maxlab-io/kiml/ATTRIBUTIONS.md

# List of Files with Custom License and Attributions

---

* File: [3d/00-kiml-optical.3dshapes/m12-120-lens.stp](3d/00-kiml-optical.3dshapes/m12-120-lens.stp)
* Author: Maksym Olender, max@maxlab.io
* License: [CC BY](https://creativecommons.org/licenses/by/4.0/)

---

* File: [3d/00-kiml-optical.3dshapes/BS612-PIR.step](3d/00-kiml-optical.3dshapes/BS612-PIR.step)
* Author: Maksym Olender, max@maxlab.io
* License: [CC BY](https://creativecommons.org/licenses/by/4.0/)

---

* File: [3d/00-kiml-optical.3dshapes/pir_lens_PD05-12005_8308-4.step](3d/00-kiml-optical.3dshapes/pir_lens_PD05-12005_8308-4.step)
* Author: Maksym Olender, max@maxlab.io
* License: [CC BY](https://creativecommons.org/licenses/by/4.0/)

---

* File: [3d/00-kiml-optical.3dshapes/IRCUT.stp](3d/00-kiml-optical.3dshapes/IRCUT.stp)
* Author: Maksym Olender, max@maxlab.io
* License: [CC BY](https://creativecommons.org/licenses/by/4.0/)

---

* File: [3d/ESP32-S3-WROOM-1U--3DModel-STEP-56544.STEP](3d/ESP32-S3-WROOM-1U--3DModel-STEP-56544.STEP)
* Author/Link: [SnapEDA](https://www.snapeda.com/parts/ESP32-S3-WROOM-1U/Espressif%20Systems/view-part/?welcome=home)
* License: [CC BY-SA](https://creativecommons.org/licenses/by/4.0/) with the [Design Exception 1.0](https://www.snapeda.com/about/FAQ/#designexception)
* See also: [SnapEDA licensing explanation](https://support.snapeda.com/en/articles/2957814-what-is-the-license-for-symbols-and-footprints)

---

* File: [3d/00-kiml-connector-rj.3dshapes/HANRUN HR911105A.stp](<3d/00-kiml-connector-rj.3dshapes/HANRUN HR911105A.stp>)
* Author: [Алексей Перевозчиков](https://grabcad.com/0030f7ec23-1)
* Link: [GrabCAD HANRUN HR911105A page](https://grabcad.com/library/hanrun-hr911105a-1)
* License: [GrabCAD License](https://grabcad.com/terms)

---

* File: [3d/00-kiml-connector-phoenix-mc.3dshapes/pxc_1843075_03_00_MCD-1-5-2-G1-3-81_3D.stp](3d/00-kiml-connector-phoenix-mc.3dshapes/pxc_1843075_03_00_MCD-1-5-2-G1-3-81_3D.stp)
* Author: Phoenix Contact
* Link: https://www.phoenixcontact.com/en-ca/products/pcb-header-mcd-15-2-g1-381-1843075

---

* File: [3d/00-kiml-connector-rj.3dshapes/HANRUN HR911105A.stp](<3d/00-kiml-connector-rj.3dshapes/HANRUN HR911105A.stp>)
* Author: [Bernd Giesecke](https://grabcad.com/bernd.giesecke-1)
* Link: [GrabCAD E22-900M22S page](https://grabcad.com/library/e22-900m22s-1)
* License: [GrabCAD License](https://grabcad.com/terms)

---

* File: [3d/00-kiml-connector-barrel-jack.3dshapes/DC_Power_Jack_PCB_Mounted_2.1mm.step](3d/00-kiml-connector-barrel-jack.3dshapes/DC_Power_Jack_PCB_Mounted_2.1mm.step)
* File: [3d/00-kiml-connector-barrel-jack.3dshapes/DC_Power_Jack_PCB_Mounted_2.1mm.wrl](3d/00-kiml-connector-barrel-jack.3dshapes/DC_Power_Jack_PCB_Mounted_2.1mm.wrl)
* Author: [Jimmy Henry](https://grabcad.com/jimmi.henry-1)
* Link: [GrabCAD DC Jack page](https://grabcad.com/library/arduino-dc-barrel-jack-2-1mm-for-kicad-1)
* License: [GrabCAD License](https://grabcad.com/terms)

---

* File: [3d/00-kiml-connector-coaxial/MM8030-2610RK0--3DModel-STEP-56544.STEP](3d/00-kiml-connector-coaxial/MM8030-2610RK0--3DModel-STEP-56544.STEP)
* Author/Link: [SnapEDA](https://www.snapeda.com/parts/MM8030-2610RK0/Murata%20Electronics/view-part/?welcome=home)
* License: [CC BY-SA](https://creativecommons.org/licenses/by/4.0/) with the [Design Exception 1.0](https://www.snapeda.com/about/FAQ/#designexception)
* See also: [SnapEDA licensing explanation](https://support.snapeda.com/en/articles/2957814-what-is-the-license-for-symbols-and-footprints)
