maxlab-io/kiml/3d/00-kiml-connector-coaxial/MM8030-2610RK0--3DModel-STEP-56544.STEP

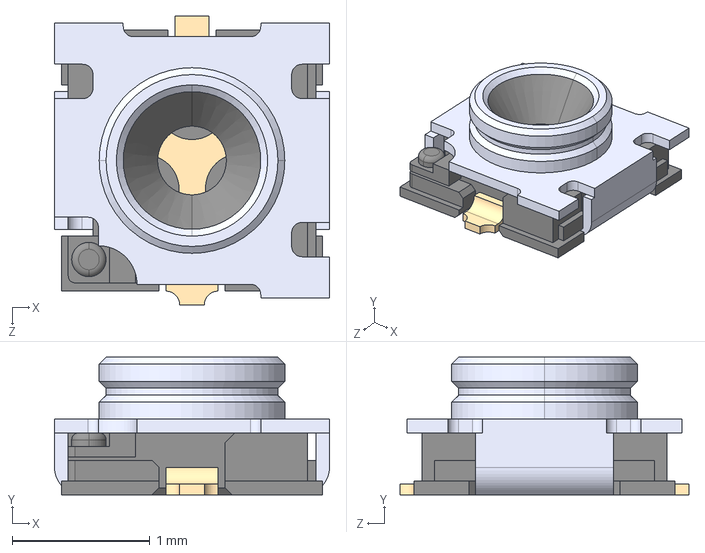
[picture p7: CAD file, 2024-01-03]
3d/00-kiml-connector-coaxial/MM8030-2610RK0--3DModel-STEP-56544.STEP
2.00 x 1.00 x 2.10 mm
