maxlab-io/kiml/(commit log)

2022-09-01 [general] defined library tree and add WR25X563JTL resistor
2022-09-01 [general] add RMC06031K1%N resistor
2022-11-02 update old resistors with better naming
2022-11-02 Add ground pad for TPS63001
2022-11-03 Add 2.2u 0603 capacitor
2022-11-04 [connector] init lib and add 10118194-0001LF usb connector
2022-11-04 [regulator_linear] init lib and add 1117 regulator
2022-11-04 [resistors] extended resistor lib with 10k/1k 0402 from jlcpcb
2022-11-04 [capacitors] init smd lib and add 22u, 100n caps
2022-11-04 [capacitors] add 10n 0402 CL05B103KB5NNNC
2022-11-04 [resistors] hide tolerance fields
2022-11-04 [power protection] init power protection library and add SRV05-4 there
2022-11-07 [resistors] fix 10K value display
2022-11-07 [button_switch_smd] init lib and add TP-02 switch
2022-11-07 [led_smd] init lib and add KT-0603R red LED
2022-11-07 [pin-header-1.27mm] init lib and add 02x10 connector
2022-11-08 [various] update switches and usb connectors library, add footprints and 3d models
2022-11-09 [logo] add footprint containing logos
2022-11-09 [resistors] fix BN -> NB in the field name
2022-11-09 [resistors] add 4.7u to resistor lib
2022-11-09 [74xGxx] fix footprint for the buffer
2022-11-10 [capacitors] fix FP for 0402 capacitor
2022-11-10 Add more components (nrf52, sensors, new DCDC)
2022-11-10 [capacitors] fix FP for 0402 capacitor - 10n
2022-11-11 Add more components:
    * 680k and 147k SMD resistors
    * TLV700028DCKR 2.8V LDO
2022-11-12 Add more SMD resistors and capacitors
2022-11-12 Add crystals and capacitors
2022-11-13 Add capacitors and inductors from the nrf52832 reference design
2022-11-13 Minor fixrs, nrf52832 pinout improvements, add 0603 4.7u capacitor
2022-11-13 Add chip antenna
2022-11-13 Add antenna matching circuit components
2022-11-14 More resistors
2022-11-16 Add NFC antenna footprint and 130p cap
2022-11-16 Add proper NFC antenna symbol
2022-11-18 Update footprint paths in old symbol definitions
2022-11-18 Add BAT46WJ low drop diode
2022-12-04 various: add a bunch of components relevant for AI camera
2022-12-09 various: new regulator, potentiometers and PIR
2022-12-17 various: buttons, connectors, LED drivers, inductors
2022-12-18 various: JST connector, battery management, 2.5R resistor
2022-12-19 various: fix DLATCH power pins, add 2x10 connector
2022-12-19 various: add missing 3d models and assigned them to footprints
2023-01-02 various: 3d models for ircut, more capacitors and leds components
2023-01-04 optical: lenses and PIR 3d models
2023-01-04 optical: add IR LEDs
2023-01-06 various: add logo footprints, 3d models for various components and update bunch of libs
2023-02-06 various: resistors, stm32f1, new crystals, rf mod
2023-02-12 EAC-23: add better stocked FPC connector and 200K pot
2023-02-12 various: battery holder, connectors, crystals, etc
2023-02-13 EAC-23: pir, resistors: add 2.43R and AS312 to the lib
2023-02-14 various: USB-C cheap connector, new resistors, new ZIF footprint
2023-02-18 EAC-2: better avail and priced fet & ALS
2023-02-18 various: battery holder, rf module footprints
2023-02-21 Add STM32G0 MCU symbol
2023-02-21 Add JST 2-ping and 3-pin XH connectors (2.5mm pitch)
2023-02-21 Add 12-pin 1mm pitch FPC connector
2023-02-21 Add TP5100 battery charging IC (1/2 cell Lithium)
2023-02-21 Add 3.3V LDO with enable PIN and minor STM32G0 symbol fixes
2023-02-21 Add 200R 0603 resistor
2023-02-23 Kicad 7 sym library update
2023-02-23 Add another 3.3V LDO
2023-02-23 Add 1N4148W diode
2023-02-23 Add another 500mA LDO
2023-02-23 Add 120k and 30k 0603 resistors
2023-02-23 Add high-current schottky diode SS34
2023-02-23 Add 0.1R 1206 resistor
2023-02-23 Add high-current 22uH inductor
2023-02-23 Add DO-214AC (diode) footprint
2023-03-01 buck converters: add AP62200TWU-7
2023-03-05 various: opamps, new battery holdes, capcitors and current sense resistors
2023-03-07 various: fix opamp missing leg
2023-03-10 various: more battery shapes and holders
2023-03-10 OP-14: fix library naming for FET lib
2023-03-11 OP-14: cheap caps, transistor array, connectors and other stuff required for light tray
2023-03-11 OP-14: fix lib fields naming for stm32g0
2023-03-16 resistors: merge old and new libraries, a few components
2023-03-16 Fix some symbols for aerator
    Add 12-pin 1mm FPC connector footprint
2023-03-17 resistors: merge old and new libraries, part 2
2023-05-03 new buttons and battery mgmt parts, esp32-s3 r8n2 chip
2023-05-08 DET-3: add TPS27081A to control camera power rails and remove old ALS from the lib
2023-05-08 DET-3: add MCP4017T, optimize TPS power switch outline
2023-05-08 DET-3: add sdcard connector, symbold, fp, 3d model
2023-05-08 DET-3: proper naming for switch libraries
2023-05-08 DET-3: add TA-3532S-A2 slide switch
2023-05-09 DET-3: add 4D03WGJ0301T5E 3.9 resistors and VSMY2853G IR LEDs
2023-05-16 DET-3: LMV358 opamp, AS451 2.5V low-power voltage ref, minor diode lib fixes
2023-05-17 cleanup: get rid of 00-resistors, move resistors to kiml, fixed some of them
2023-05-17 cleanup: get rid of 02-capacitors, move caps to 00-kiml, cleanup pending
2023-05-17 cleanup: fix some resistors in the lib
2023-05-17 cleanup: fix more resistors in the lib
2023-05-18 cleanup: absorbed power library, delete old files
2023-05-18 cleanup: absorbed connector library, delete old files
2023-05-18 cleanup: migrate SMD LEDs to kiml main library
2023-05-18 cleanup: absorb sensor library, delete old files
2023-05-18 cleanup: absorb switches library, delete old files
2023-05-18 cleanup: absorb led library, delete old files
2023-05-19 cleanup: move old footprints to unsorted library
2023-05-20 cleanup: point footprints to prorietary 3D models paths
2023-05-21 cleanup: fix links to 3d models for connectors and buttons
2023-06-06 add WS2812B RGB LED
2023-06-18 misc: various nifty parts in small footprints
2023-06-18 misc: more of various nifty parts in small footprints
2023-06-19 misc: add ADC lib and ESP32-S3-WROOM-U variant
2023-06-19 misc: lots of goodies and connectors
2023-06-20 ESP32: add S3-WROOM-U1 3d model and footprint
2023-06-20 misc: connectors and goodies
2023-06-21 connectors: phoenix 2 row 2 pin MC clone and attributions
2023-06-21 rj45: add RJ45_RJ45-B-1_4 connector from BOOMELEC
2023-06-22 rj45: better couryard and SH pin for RJ45_RJ45-B-1_4
2023-06-26 misc: RJ45 connector from BOOMELEC
2023-06-27 misc: RJ45 connector fixes and 5V TVS in a small package
2023-07-05 connectors: add DC barrel jack
2023-08-12 mics: new parts for USB/UART interface
2023-08-15 misc: fix voltage ref and improve slide orientation annotation
2023-08-22 regulator: proper pin def for LD39200DPUR
2023-09-30 stm32f3: add a lib and a STM32F303RBT6 part
2023-11-01 regulator: add XC6206P332MR
2023-11-01 resistors: add RC0402FR-072ML
2023-11-01 resistors: add CR0402FF5622G
2023-11-28 sensor-motion: Add LSM303AGRTR
    The LSM303AGR is an ultralow-power high-performance system-in-package
    featuring a 3-axis digital linear acceleration sensor and
    a 3-axis digital magnetic sensor.
2023-12-04 Proper symbol shape and footprint association
2023-12-04 Use footprint from Kicad
    Use Package_LGA:LGA-12_2x2mm_P0.5mm and remove
    footprints/00-kiml-unsorted.pretty/LGA-12L_2x2x1mm.kicad_mod
2024-01-03 add rf test connector from Murata
2024-01-03 add rf test connector - 3d model
    [MM8030-2610RK0--3DModel-STEP-56544.STEP]
2024-01-23 stm32f1: STM32F103CBT6
2024-02-20 bunch of symbols, footprints and improvements
2024-03-30 fix SPN for JST connector and new ircut for ov2640 fp
2024-04-02 haptic/vibro motor and SMA connectors
2024-05-04 switches: new slide switch
2024-07-27 Convert libraries to Kicad 8
2024-07-27 inductors: add BLM18EG471SN1D
    210mΩ ±25% 470Ω@100MHz 0603 Ferrite Beads ROHS
2024-07-27 resistors: add 0402WGF4701TCE
    62.5mW Thick Film Resistors 50V ±100ppm/℃ ±1% 4.7kΩ 0402 Chip Resistor
    Surface Mount ROHS
2024-07-27 capacitors: add GRM1555C1H100FA01D
    50V 10pF C0G ±1% 0402 Multilayer Ceramic Capacitors MLCC
    SMD/SMT ROHS
2024-07-27 capacitors: add GJM1555C1H5R6WB01D
    50V 5.6pF null 0402 Multilayer Ceramic Capacitors MLCC - SMD/SMT ROHS
2024-10-22 new connectors and crystals
