maxlab-io/kiml/(notices)

Notices in the files:
README.md:
CC BY 4.0
